Darren-Loh/FPGA-Game-Struct/README.md

# FPGA-Game-Struct
50.002 Computation Structures 1D Game Project 

 - Project Report: `1D Proj Group Report 13-3.pdf`
 - [Project Showcase](https://istd.sutd.edu.sg/term4-design-exhibition/compstruct/Simon's-Windows/)
 - [Project Video](https://vimeo.com/486618029)

## Contributors:
@Darren-Loh @Sorahawk @khliyh @LoJunKai
