Darren-Loh/FPGA-Game-Struct/work/vivado/FPGA-Game-Struct/FPGA-Game-Struct.runs/impl_1/.init_design.begin.rst

<?xml version="1.0"?>
<ProcessHandle Version="1" Minor="0">
    <Process Command=".planAhead." Owner="JK" Host="LAPTOP-IC7HNLMF" Pid="28636">
    </Process>
</ProcessHandle>
