Darren-Loh/FPGA-Game-Struct/work/vivado/FPGA-Game-Struct/FPGA-Game-Struct.runs/impl_1/.vivado.begin.rst

<?xml version="1.0"?>
<ProcessHandle Version="1" Minor="0">
    <Process Command="vivado.bat" Owner="JK" Host="LAPTOP-IC7HNLMF" Pid="264" HostCore="8" HostMemory="08461193216">
    </Process>
</ProcessHandle>
