Darren-Loh/FPGA-Game-Struct/work/constraint/custom.xdc

# clk => 100000000Hz
create_clock -period 10.0 -name clk_0 -waveform {0.000 5.000} [get_ports clk]
set_property PACKAGE_PIN C3 [get_ports {buzz[0]}]
set_property IOSTANDARD LVCMOS33 [get_ports {buzz[0]}]
set_property PACKAGE_PIN C1 [get_ports {buzz[1]}]
set_property IOSTANDARD LVCMOS33 [get_ports {buzz[1]}]
set_property PACKAGE_PIN N12 [get_ports {rgb_led[0]}]
set_property IOSTANDARD LVCMOS33 [get_ports {rgb_led[0]}]
set_property PACKAGE_PIN N11 [get_ports {rgb_led[1]}]
set_property IOSTANDARD LVCMOS33 [get_ports {rgb_led[1]}]
set_property PACKAGE_PIN P11 [get_ports {rgb_led[2]}]
set_property IOSTANDARD LVCMOS33 [get_ports {rgb_led[2]}]
set_property PACKAGE_PIN P10 [get_ports {rgb_led[3]}]
set_property IOSTANDARD LVCMOS33 [get_ports {rgb_led[3]}]
set_property PACKAGE_PIN T3 [get_ports {button[0]}]
set_property IOSTANDARD LVCMOS33 [get_ports {button[0]}]
set_property PULLDOWN true [get_ports {button[0]}]
set_property PACKAGE_PIN T4 [get_ports {button[1]}]
set_property IOSTANDARD LVCMOS33 [get_ports {button[1]}]
set_property PULLDOWN true [get_ports {button[1]}]
set_property PACKAGE_PIN T2 [get_ports {button[2]}]
set_property IOSTANDARD LVCMOS33 [get_ports {button[2]}]
set_property PULLDOWN true [get_ports {button[2]}]
set_property PACKAGE_PIN R3 [get_ports {button[3]}]
set_property IOSTANDARD LVCMOS33 [get_ports {button[3]}]
set_property PULLDOWN true [get_ports {button[3]}]
set_property PACKAGE_PIN R10 [get_ports {rst_n}]
set_property IOSTANDARD LVCMOS33 [get_ports {rst_n}]
set_property PULLDOWN true [get_ports {rst_n}]
set_property PACKAGE_PIN N14 [get_ports {clk}]
set_property IOSTANDARD LVCMOS33 [get_ports {clk}]
set_property PACKAGE_PIN K13 [get_ports {led[0]}]
set_property IOSTANDARD LVCMOS33 [get_ports {led[0]}]
set_property PACKAGE_PIN K12 [get_ports {led[1]}]
set_property IOSTANDARD LVCMOS33 [get_ports {led[1]}]
set_property PACKAGE_PIN L14 [get_ports {led[2]}]
set_property IOSTANDARD LVCMOS33 [get_ports {led[2]}]
set_property PACKAGE_PIN L13 [get_ports {led[3]}]
set_property IOSTANDARD LVCMOS33 [get_ports {led[3]}]
set_property PACKAGE_PIN M16 [get_ports {led[4]}]
set_property IOSTANDARD LVCMOS33 [get_ports {led[4]}]
set_property PACKAGE_PIN M14 [get_ports {led[5]}]
set_property IOSTANDARD LVCMOS33 [get_ports {led[5]}]
set_property PACKAGE_PIN M12 [get_ports {led[6]}]
set_property IOSTANDARD LVCMOS33 [get_ports {led[6]}]
set_property PACKAGE_PIN N16 [get_ports {led[7]}]
set_property IOSTANDARD LVCMOS33 [get_ports {led[7]}]
set_property PACKAGE_PIN P15 [get_ports {usb_rx}]
set_property IOSTANDARD LVCMOS33 [get_ports {usb_rx}]
set_property PACKAGE_PIN P16 [get_ports {usb_tx}]
set_property IOSTANDARD LVCMOS33 [get_ports {usb_tx}]
set_property PACKAGE_PIN B6 [get_ports {io_led[0]}]
set_property IOSTANDARD LVCMOS33 [get_ports {io_led[0]}]
set_property PACKAGE_PIN B5 [get_ports {io_led[1]}]
set_property IOSTANDARD LVCMOS33 [get_ports {io_led[1]}]
set_property PACKAGE_PIN A5 [get_ports {io_led[2]}]
set_property IOSTANDARD LVCMOS33 [get_ports {io_led[2]}]
set_property PACKAGE_PIN A4 [get_ports {io_led[3]}]
set_property IOSTANDARD LVCMOS33 [get_ports {io_led[3]}]
set_property PACKAGE_PIN B4 [get_ports {io_led[4]}]
set_property IOSTANDARD LVCMOS33 [get_ports {io_led[4]}]
set_property PACKAGE_PIN A3 [get_ports {io_led[5]}]
set_property IOSTANDARD LVCMOS33 [get_ports {io_led[5]}]
set_property PACKAGE_PIN F4 [get_ports {io_led[6]}]
set_property IOSTANDARD LVCMOS33 [get_ports {io_led[6]}]
set_property PACKAGE_PIN F3 [get_ports {io_led[7]}]
set_property IOSTANDARD LVCMOS33 [get_ports {io_led[7]}]
set_property PACKAGE_PIN F2 [get_ports {io_led[8]}]
set_property IOSTANDARD LVCMOS33 [get_ports {io_led[8]}]
set_property PACKAGE_PIN E1 [get_ports {io_led[9]}]
set_property IOSTANDARD LVCMOS33 [get_ports {io_led[9]}]
set_property PACKAGE_PIN B2 [get_ports {io_led[10]}]
set_property IOSTANDARD LVCMOS33 [get_ports {io_led[10]}]
set_property PACKAGE_PIN A2 [get_ports {io_led[11]}]
set_property IOSTANDARD LVCMOS33 [get_ports {io_led[11]}]
set_property PACKAGE_PIN E2 [get_ports {io_led[12]}]
set_property IOSTANDARD LVCMOS33 [get_ports {io_led[12]}]
set_property PACKAGE_PIN D1 [get_ports {io_led[13]}]
set_property IOSTANDARD LVCMOS33 [get_ports {io_led[13]}]
set_property PACKAGE_PIN E6 [get_ports {io_led[14]}]
set_property IOSTANDARD LVCMOS33 [get_ports {io_led[14]}]
set_property PACKAGE_PIN K5 [get_ports {io_led[15]}]
set_property IOSTANDARD LVCMOS33 [get_ports {io_led[15]}]
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
set_property IOSTANDARD LVCMOS33 [get_ports {io_dip[20]}]
set_property PULLDOWN true [get_ports {io_dip[20]}]
set_property PACKAGE_PIN J4 [get_ports {io_dip[21]}]
set_property IOSTANDARD LVCMOS33 [get_ports {io_dip[21]}]
set_property PULLDOWN true [get_ports {io_dip[21]}]
set_property PACKAGE_PIN K3 [get_ports {io_dip[22]}]
set_property IOSTANDARD LVCMOS33 [get_ports {io_dip[22]}]
set_property PULLDOWN true [get_ports {io_dip[22]}]
set_property PACKAGE_PIN K2 [get_ports {io_dip[23]}]
set_property IOSTANDARD LVCMOS33 [get_ports {io_dip[23]}]
set_property PULLDOWN true [get_ports {io_dip[23]}]
set_property PACKAGE_PIN C6 [get_ports {io_button[0]}]
set_property IOSTANDARD LVCMOS33 [get_ports {io_button[0]}]
set_property PULLDOWN true [get_ports {io_button[0]}]
set_property PACKAGE_PIN C7 [get_ports {io_button[1]}]
set_property IOSTANDARD LVCMOS33 [get_ports {io_button[1]}]
set_property PULLDOWN true [get_ports {io_button[1]}]
set_property PACKAGE_PIN A7 [get_ports {io_button[2]}]
set_property IOSTANDARD LVCMOS33 [get_ports {io_button[2]}]
set_property PULLDOWN true [get_ports {io_button[2]}]
set_property PACKAGE_PIN B7 [get_ports {io_button[3]}]
set_property IOSTANDARD LVCMOS33 [get_ports {io_button[3]}]
set_property PULLDOWN true [get_ports {io_button[3]}]
set_property PACKAGE_PIN P11 [get_ports {io_button[4]}]
set_property IOSTANDARD LVCMOS33 [get_ports {io_button[4]}]
set_property PULLDOWN true [get_ports {io_button[4]}]
set_property PACKAGE_PIN P8 [get_ports {io_sel[0]}]
set_property IOSTANDARD LVCMOS33 [get_ports {io_sel[0]}]
set_property PACKAGE_PIN R8 [get_ports {io_sel[1]}]
set_property IOSTANDARD LVCMOS33 [get_ports {io_sel[1]}]
set_property PACKAGE_PIN N9 [get_ports {io_sel[2]}]
set_property IOSTANDARD LVCMOS33 [get_ports {io_sel[2]}]
set_property PACKAGE_PIN P9 [get_ports {io_sel[3]}]
set_property IOSTANDARD LVCMOS33 [get_ports {io_sel[3]}]
set_property PACKAGE_PIN T5 [get_ports {io_seg[0]}]
set_property IOSTANDARD LVCMOS33 [get_ports {io_seg[0]}]
set_property PACKAGE_PIN R5 [get_ports {io_seg[1]}]
set_property IOSTANDARD LVCMOS33 [get_ports {io_seg[1]}]
set_property PACKAGE_PIN T9 [get_ports {io_seg[2]}]
set_property IOSTANDARD LVCMOS33 [get_ports {io_seg[2]}]
set_property PACKAGE_PIN R6 [get_ports {io_seg[3]}]
set_property IOSTANDARD LVCMOS33 [get_ports {io_seg[3]}]
set_property PACKAGE_PIN R7 [get_ports {io_seg[4]}]
set_property IOSTANDARD LVCMOS33 [get_ports {io_seg[4]}]
set_property PACKAGE_PIN T7 [get_ports {io_seg[5]}]
set_property IOSTANDARD LVCMOS33 [get_ports {io_seg[5]}]
set_property PACKAGE_PIN T8 [get_ports {io_seg[6]}]
set_property IOSTANDARD LVCMOS33 [get_ports {io_seg[6]}]
set_property PACKAGE_PIN T10 [get_ports {io_seg[7]}]
set_property IOSTANDARD LVCMOS33 [get_ports {io_seg[7]}]
