Darren-Loh/FPGA-Game-Struct/work/vivado/FPGA-Game-Struct/FPGA-Game-Struct.runs/synth_1/.Xil/au_top_0_propImpl.xdc

set_property SRC_FILE_INFO {cfile:{C:/Users/JK/Desktop/Comp Struct/Alchitry Au/FPGA-Game-Struct/work/constraint/custom.xdc} rfile:../../../../../constraint/custom.xdc id:1} [current_design]
set_property src_info {type:XDC file:1 line:3 export:INPUT save:INPUT read:READ} [current_design]
set_property PACKAGE_PIN C3 [get_ports {buzz[0]}]
set_property src_info {type:XDC file:1 line:5 export:INPUT save:INPUT read:READ} [current_design]
set_property PACKAGE_PIN C1 [get_ports {buzz[1]}]
set_property src_info {type:XDC file:1 line:7 export:INPUT save:INPUT read:READ} [current_design]
set_property PACKAGE_PIN N12 [get_ports {rgb_led[0]}]
set_property src_info {type:XDC file:1 line:9 export:INPUT save:INPUT read:READ} [current_design]
set_property PACKAGE_PIN N11 [get_ports {rgb_led[1]}]
set_property src_info {type:XDC file:1 line:11 export:INPUT save:INPUT read:READ} [current_design]
set_property PACKAGE_PIN P11 [get_ports {rgb_led[2]}]
set_property src_info {type:XDC file:1 line:13 export:INPUT save:INPUT read:READ} [current_design]
set_property PACKAGE_PIN P10 [get_ports {rgb_led[3]}]
set_property src_info {type:XDC file:1 line:15 export:INPUT save:INPUT read:READ} [current_design]
set_property PACKAGE_PIN T3 [get_ports {button[0]}]
set_property src_info {type:XDC file:1 line:18 export:INPUT save:INPUT read:READ} [current_design]
set_property PACKAGE_PIN T4 [get_ports {button[1]}]
set_property src_info {type:XDC file:1 line:21 export:INPUT save:INPUT read:READ} [current_design]
set_property PACKAGE_PIN T2 [get_ports {button[2]}]
set_property src_info {type:XDC file:1 line:24 export:INPUT save:INPUT read:READ} [current_design]
set_property PACKAGE_PIN R3 [get_ports {button[3]}]
set_property src_info {type:XDC file:1 line:27 export:INPUT save:INPUT read:READ} [current_design]
set_property PACKAGE_PIN R10 [get_ports {rst_n}]
set_property src_info {type:XDC file:1 line:30 export:INPUT save:INPUT read:READ} [current_design]
set_property PACKAGE_PIN N14 [get_ports {clk}]
set_property src_info {type:XDC file:1 line:32 export:INPUT save:INPUT read:READ} [current_design]
set_property PACKAGE_PIN K13 [get_ports {led[0]}]
set_property src_info {type:XDC file:1 line:34 export:INPUT save:INPUT read:READ} [current_design]
set_property PACKAGE_PIN K12 [get_ports {led[1]}]
set_property src_info {type:XDC file:1 line:36 export:INPUT save:INPUT read:READ} [current_design]
set_property PACKAGE_PIN L14 [get_ports {led[2]}]
set_property src_info {type:XDC file:1 line:38 export:INPUT save:INPUT read:READ} [current_design]
set_property PACKAGE_PIN L13 [get_ports {led[3]}]
set_property src_info {type:XDC file:1 line:40 export:INPUT save:INPUT read:READ} [current_design]
set_property PACKAGE_PIN M16 [get_ports {led[4]}]
set_property src_info {type:XDC file:1 line:42 export:INPUT save:INPUT read:READ} [current_design]
set_property PACKAGE_PIN M14 [get_ports {led[5]}]
set_property src_info {type:XDC file:1 line:44 export:INPUT save:INPUT read:READ} [current_design]
set_property PACKAGE_PIN M12 [get_ports {led[6]}]
set_property src_info {type:XDC file:1 line:46 export:INPUT save:INPUT read:READ} [current_design]
set_property PACKAGE_PIN N16 [get_ports {led[7]}]
set_property src_info {type:XDC file:1 line:48 export:INPUT save:INPUT read:READ} [current_design]
set_property PACKAGE_PIN P15 [get_ports {usb_rx}]
set_property src_info {type:XDC file:1 line:50 export:INPUT save:INPUT read:READ} [current_design]
set_property PACKAGE_PIN P16 [get_ports {usb_tx}]
set_property src_info {type:XDC file:1 line:52 export:INPUT save:INPUT read:READ} [current_design]
set_property PACKAGE_PIN B6 [get_ports {io_led[0]}]
set_property src_info {type:XDC file:1 line:54 export:INPUT save:INPUT read:READ} [current_design]
set_property PACKAGE_PIN B5 [get_ports {io_led[1]}]
set_property src_info {type:XDC file:1 line:56 export:INPUT save:INPUT read:READ} [current_design]
set_property PACKAGE_PIN A5 [get_ports {io_led[2]}]
set_property src_info {type:XDC file:1 line:58 export:INPUT save:INPUT read:READ} [current_design]
set_property PACKAGE_PIN A4 [get_ports {io_led[3]}]
set_property src_info {type:XDC file:1 line:60 export:INPUT save:INPUT read:READ} [current_design]
set_property PACKAGE_PIN B4 [get_ports {io_led[4]}]
set_property src_info {type:XDC file:1 line:62 export:INPUT save:INPUT read:READ} [current_design]
set_property PACKAGE_PIN A3 [get_ports {io_led[5]}]
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
set_property src_info {type:XDC file:1 line:130 export:INPUT save:INPUT read:READ} [current_design]
set_property PACKAGE_PIN C3 [get_ports {io_dip[10]}]
set_property src_info {type:XDC file:1 line:133 export:INPUT save:INPUT read:READ} [current_design]
set_property PACKAGE_PIN C2 [get_ports {io_dip[11]}]
set_property src_info {type:XDC file:1 line:136 export:INPUT save:INPUT read:READ} [current_design]
set_property PACKAGE_PIN C1 [get_ports {io_dip[12]}]
set_property src_info {type:XDC file:1 line:139 export:INPUT save:INPUT read:READ} [current_design]
set_property PACKAGE_PIN B1 [get_ports {io_dip[13]}]
set_property src_info {type:XDC file:1 line:142 export:INPUT save:INPUT read:READ} [current_design]
set_property PACKAGE_PIN M6 [get_ports {io_dip[14]}]
set_property src_info {type:XDC file:1 line:145 export:INPUT save:INPUT read:READ} [current_design]
set_property PACKAGE_PIN N6 [get_ports {io_dip[15]}]
set_property src_info {type:XDC file:1 line:148 export:INPUT save:INPUT read:READ} [current_design]
set_property PACKAGE_PIN H5 [get_ports {io_dip[16]}]
set_property src_info {type:XDC file:1 line:151 export:INPUT save:INPUT read:READ} [current_design]
set_property PACKAGE_PIN H4 [get_ports {io_dip[17]}]
set_property src_info {type:XDC file:1 line:154 export:INPUT save:INPUT read:READ} [current_design]
set_property PACKAGE_PIN J3 [get_ports {io_dip[18]}]
set_property src_info {type:XDC file:1 line:157 export:INPUT save:INPUT read:READ} [current_design]
set_property PACKAGE_PIN H3 [get_ports {io_dip[19]}]
set_property src_info {type:XDC file:1 line:160 export:INPUT save:INPUT read:READ} [current_design]
set_property PACKAGE_PIN J5 [get_ports {io_dip[20]}]
set_property src_info {type:XDC file:1 line:163 export:INPUT save:INPUT read:READ} [current_design]
set_property PACKAGE_PIN J4 [get_ports {io_dip[21]}]
set_property src_info {type:XDC file:1 line:166 export:INPUT save:INPUT read:READ} [current_design]
set_property PACKAGE_PIN K3 [get_ports {io_dip[22]}]
set_property src_info {type:XDC file:1 line:169 export:INPUT save:INPUT read:READ} [current_design]
set_property PACKAGE_PIN K2 [get_ports {io_dip[23]}]
set_property src_info {type:XDC file:1 line:172 export:INPUT save:INPUT read:READ} [current_design]
set_property PACKAGE_PIN C6 [get_ports {io_button[0]}]
set_property src_info {type:XDC file:1 line:175 export:INPUT save:INPUT read:READ} [current_design]
set_property PACKAGE_PIN C7 [get_ports {io_button[1]}]
set_property src_info {type:XDC file:1 line:178 export:INPUT save:INPUT read:READ} [current_design]
set_property PACKAGE_PIN A7 [get_ports {io_button[2]}]
set_property src_info {type:XDC file:1 line:181 export:INPUT save:INPUT read:READ} [current_design]
set_property PACKAGE_PIN B7 [get_ports {io_button[3]}]
set_property src_info {type:XDC file:1 line:184 export:INPUT save:INPUT read:READ} [current_design]
set_property PACKAGE_PIN P11 [get_ports {io_button[4]}]
set_property src_info {type:XDC file:1 line:187 export:INPUT save:INPUT read:READ} [current_design]
set_property PACKAGE_PIN P8 [get_ports {io_sel[0]}]
set_property src_info {type:XDC file:1 line:189 export:INPUT save:INPUT read:READ} [current_design]
set_property PACKAGE_PIN R8 [get_ports {io_sel[1]}]
set_property src_info {type:XDC file:1 line:191 export:INPUT save:INPUT read:READ} [current_design]
set_property PACKAGE_PIN N9 [get_ports {io_sel[2]}]
set_property src_info {type:XDC file:1 line:193 export:INPUT save:INPUT read:READ} [current_design]
set_property PACKAGE_PIN P9 [get_ports {io_sel[3]}]
set_property src_info {type:XDC file:1 line:195 export:INPUT save:INPUT read:READ} [current_design]
set_property PACKAGE_PIN T5 [get_ports {io_seg[0]}]
set_property src_info {type:XDC file:1 line:197 export:INPUT save:INPUT read:READ} [current_design]
set_property PACKAGE_PIN R5 [get_ports {io_seg[1]}]
set_property src_info {type:XDC file:1 line:199 export:INPUT save:INPUT read:READ} [current_design]
set_property PACKAGE_PIN T9 [get_ports {io_seg[2]}]
set_property src_info {type:XDC file:1 line:201 export:INPUT save:INPUT read:READ} [current_design]
set_property PACKAGE_PIN R6 [get_ports {io_seg[3]}]
set_property src_info {type:XDC file:1 line:203 export:INPUT save:INPUT read:READ} [current_design]
set_property PACKAGE_PIN R7 [get_ports {io_seg[4]}]
set_property src_info {type:XDC file:1 line:205 export:INPUT save:INPUT read:READ} [current_design]
set_property PACKAGE_PIN T7 [get_ports {io_seg[5]}]
set_property src_info {type:XDC file:1 line:207 export:INPUT save:INPUT read:READ} [current_design]
set_property PACKAGE_PIN T8 [get_ports {io_seg[6]}]
set_property src_info {type:XDC file:1 line:209 export:INPUT save:INPUT read:READ} [current_design]
set_property PACKAGE_PIN T10 [get_ports {io_seg[7]}]
